lensdigital/SquareMote/R0/readme.txt

Schematic and Board files can be found here.
