lensdigital/SquareMote/R2/firmware/readme.md

Various firmware for Squaremote R2 and R2.5
Mostly for Temperature Humidity Sensors for Xronos Clocks
