lensdigital/SquareMote/R0/R0_2_PCB.png

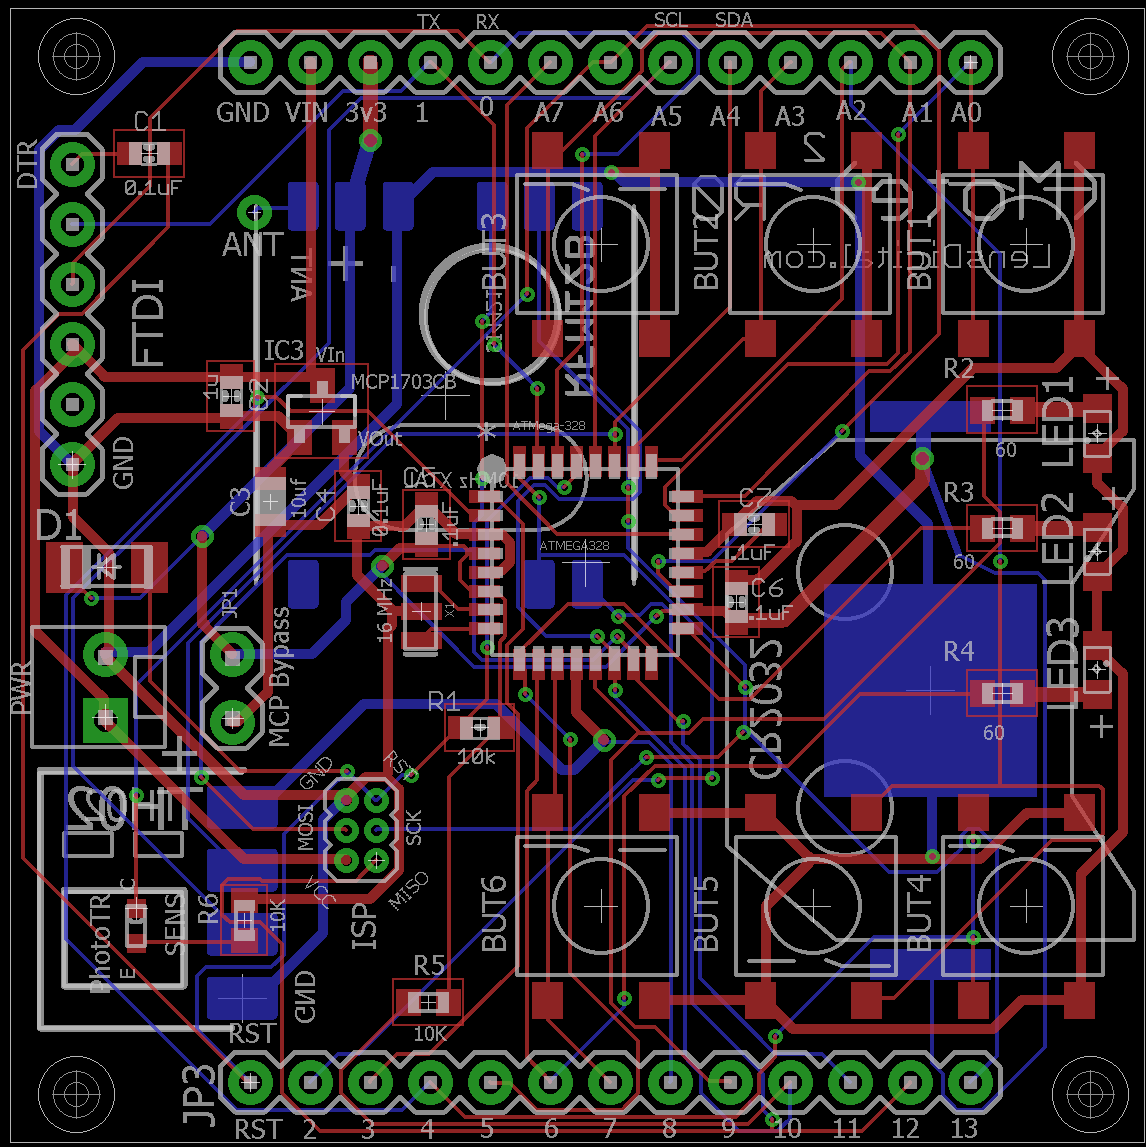
R0/R0_2_PCB.png
