lensdigital/SquareMote/R0/R0_2_Schematic.png

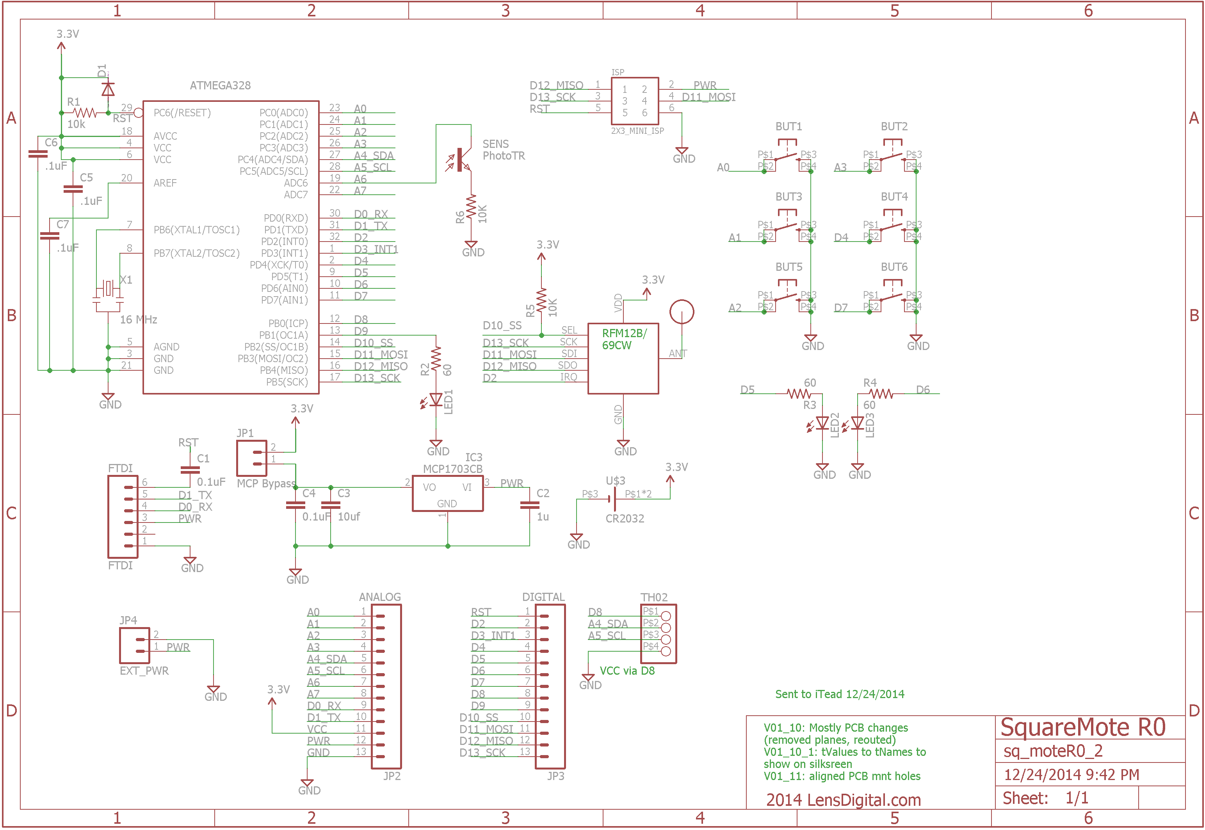
R0/R0_2_Schematic.png
