lensdigital/SquareMote/(commit log)

2016-03-01 Create boards.txt
    8Mhz version of Squaremote. Use ATmega328p @ 8Mhz LensDigital profile.
2016-03-01 Uploaded PNG of schematic and board
2016-03-01 Moved file to Arduino Code folder
2018-09-27 Latest Squaremote Weather Sensor Sketch
    Version 12. Compatible with both RFM69, RFM12 transceivers as well as TH02 and Si7021 temperature/humidity sensors
